machadoleonardo94/Brewers_control_panel/zero-crossing/zero-crossing.step

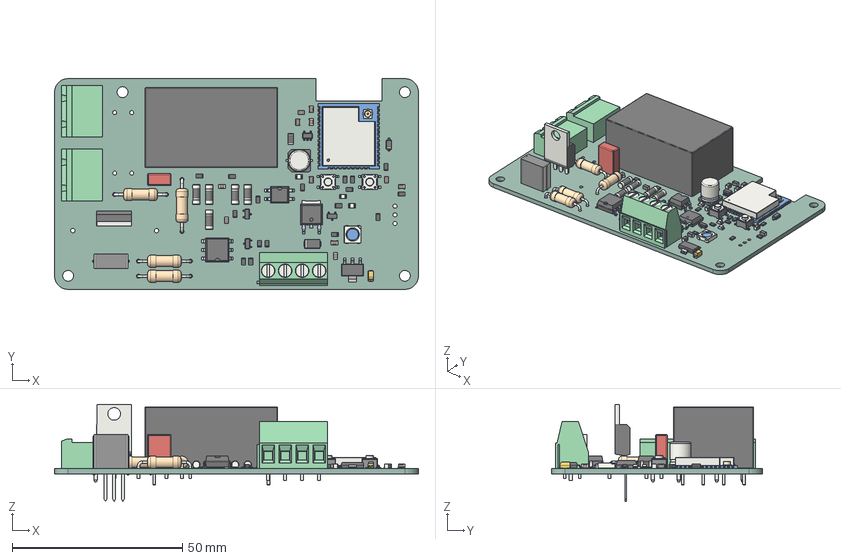
[picture p1: CAD file, 2026-02-01]
zero-crossing/zero-crossing.step
107.0 x 62.0 x 28.5 mm
C_0805_2012Metric x 10
SW_SPST_PTS647Sx38 x 2
R_0805_2012Metric x 17
SMDIP_4_W762mm
D_MELF_Standard x 5
LED_0805_2012Metric x 3
SOT_223
C_Rect_L110mm_W43mm_P1000mm_MKT
C_Elec_63x77
SMDIP_6_W953mm
CQ assembly
D_SOD_123
SOT_23 x 3
TO-220-3_Vertical
LED_WS2812B_PLCC4_50x50mm_P32mm
R_Axial_DIN0411_L99mm_D36mm_P1524mm_Horizontal x 4
ESP32-WROOM-32U
C_Rect_L70mm_W35mm_P500mm
GMSTBA_01x02_G_7_62mm x 2
Converter_ACDC_Hi-Link_HLK-5Mxx
L_0805_2012Metric
TerminalBlock_Phoenix_MKDS_15_4_1x04_P500mm_Horizontal
SOT_23_5
CP_EIA_3216_18_Kemet_A
Fuse_1206_3216Metric
D_SMA
zero-crossing_PCB
