machadoleonardo94/Brewers_control_panel/zero-crossing/zero-crossing.pdf

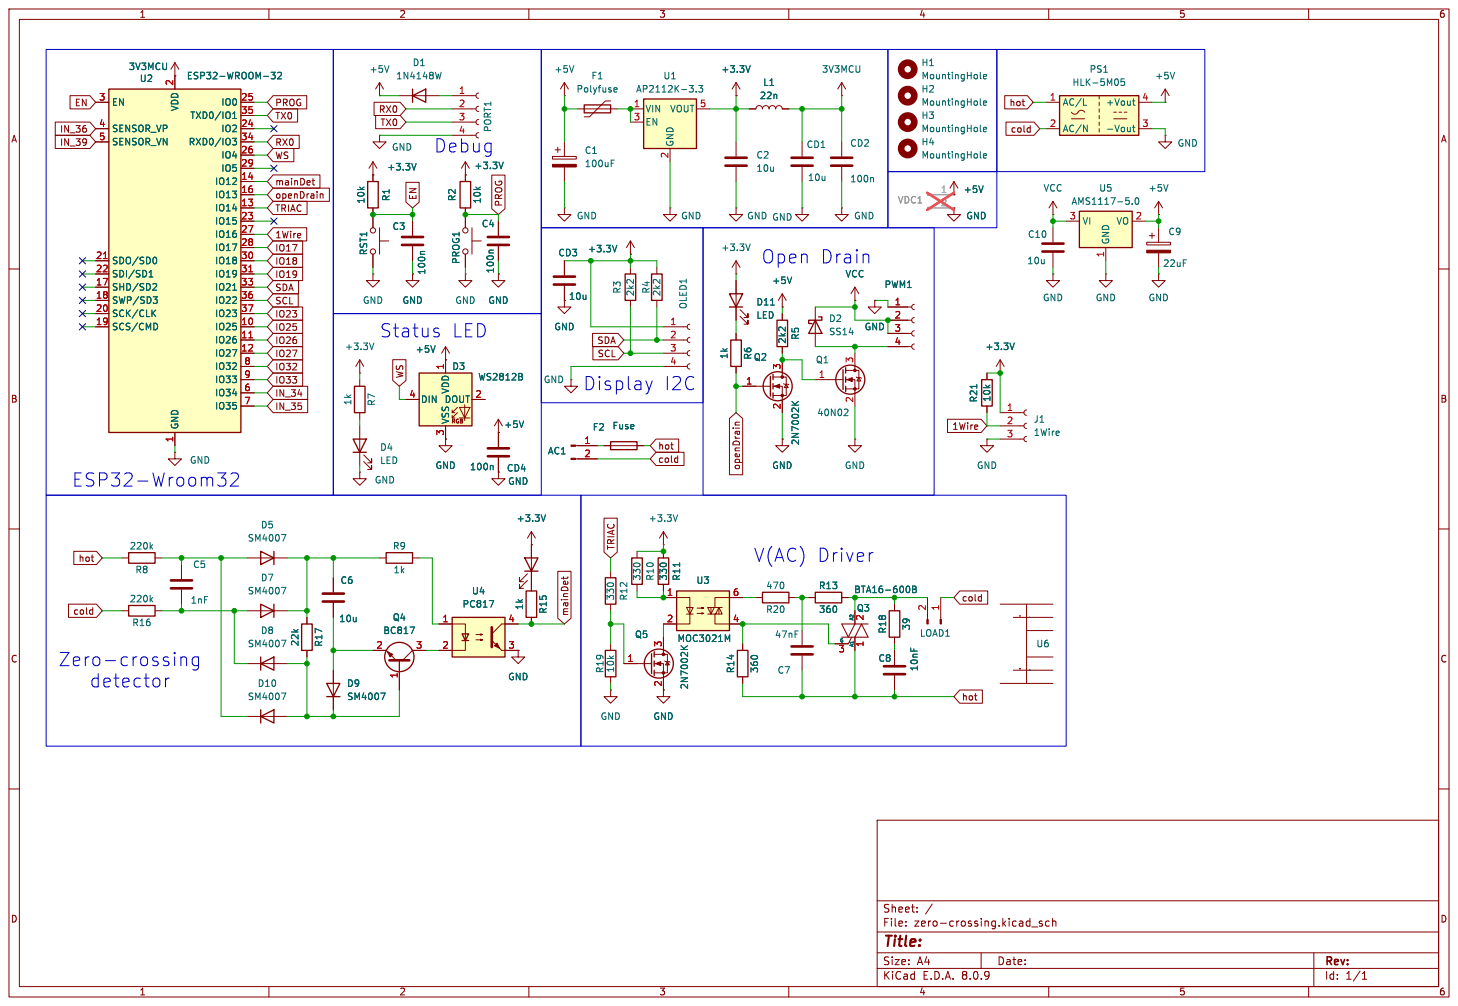
[picture p2: page 1]

2 SCK/CLK 20 SDO/SD0 21 SDI/SD1 22

Id: 1/1 Title: File: zero-crossing.kicad_sch Sheet: /
