machadoleonardo94/Brewers_control_panel/zero-crossing/zero-crossing.kicad_pcb

## KiCad design zero-crossing/zero-crossing.kicad_pcb (2026-02-01)

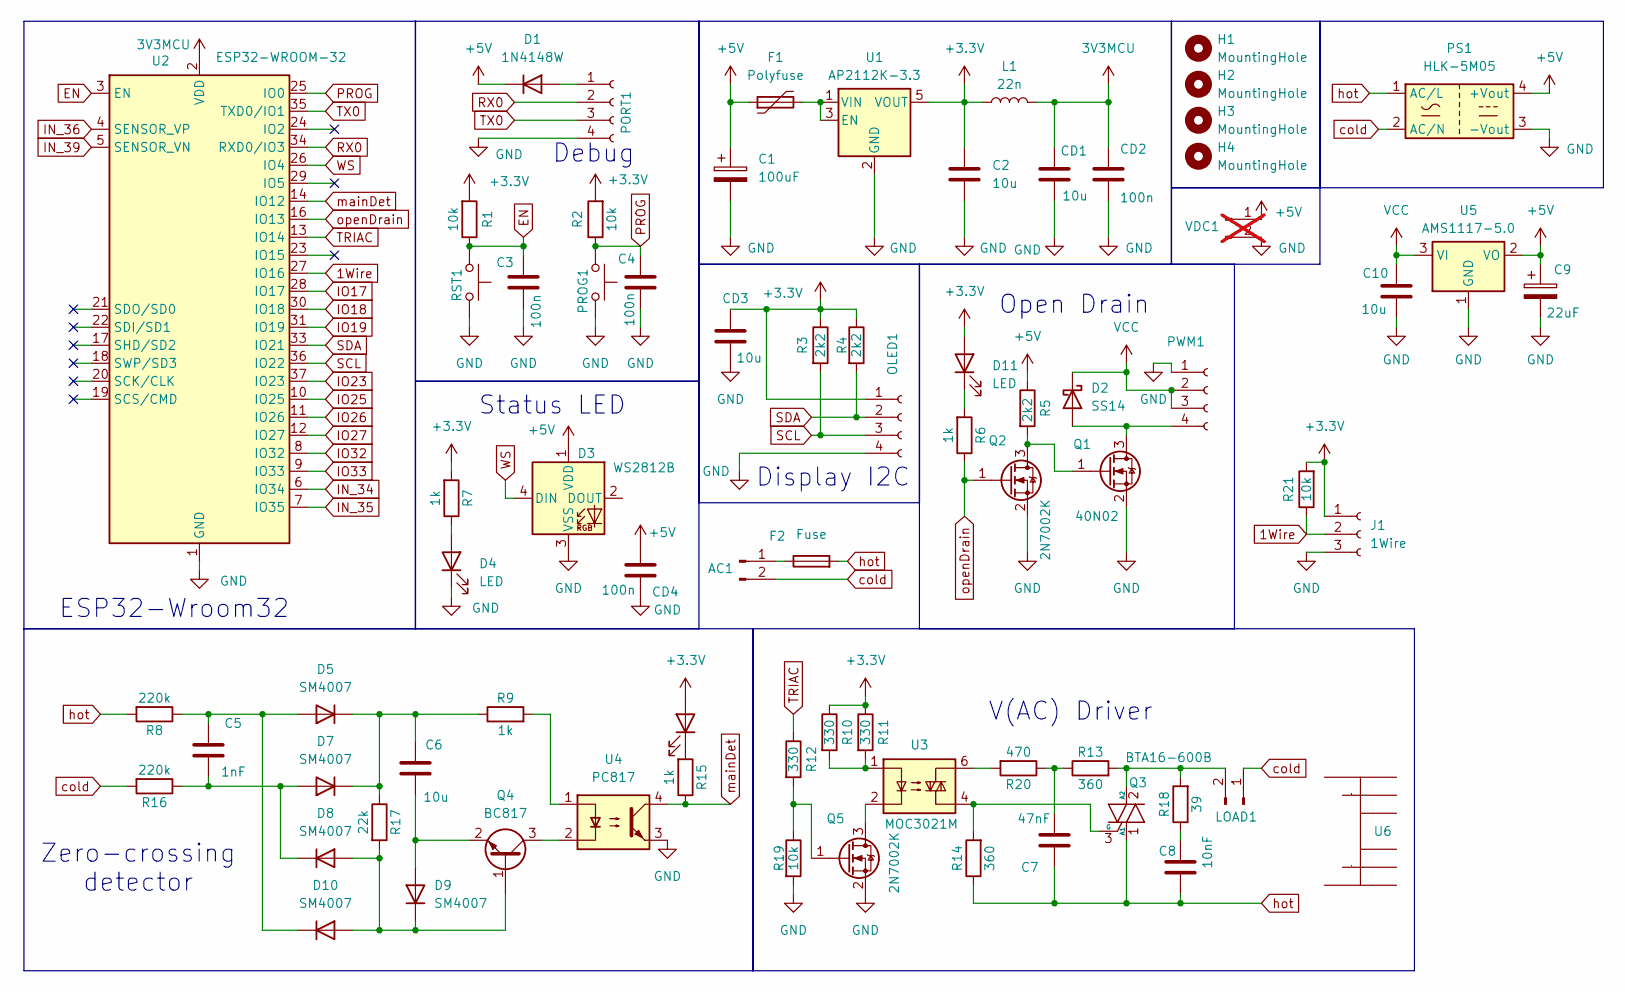
[picture p3: schematic zero-crossing.kicad_sch]

Parts:
AC1: Conn_01x02_Pin; PhoenixContact_GMSTBA_2,5_2-G-7,62_1x02_P7.62mm_Horizontal
C1: 100uF; C_Elec_6.3x7.7; LCSC C99837
C2, C6, C10: 10u; C_0805_2012Metric; LCSC C77075
C3, C4: 100n; C_0805_2012Metric; LCSC C2909631
C5: 1nF; C_0805_2012Metric; Part Number C0805C104J5RALTU; LCSC C2909631
C7: 47nF; C_Rect_L11.0mm_W4.3mm_P10.00mm_MKT; Part Number C0805C104J5RALTU; LCSC C2909631
C8: 10nF; C_Rect_L7.0mm_W3.5mm_P5.00mm; Part Number C0805C104J5RALTU; LCSC C2909631
C9: 22uF; CP_EIA-3216-18_Kemet-A_Pad1.58x1.35mm_HandSolder
CD1, CD3: 10u; C_0805_2012Metric; LCSC C77075
CD2, CD4: 100n; C_0805_2012Metric; LCSC C2909631
D1: 1N4148W; D_SOD-123; LCSC C82544
D2: SS14; D_SMA; LCSC C2909920
D3: WS2812B; LED_WS2812B_PLCC4_5.0x5.0mm_P3.2mm; LCSC 1
D4, D6, D11: LED; LED_0805_2012Metric_Pad1.15x1.40mm_HandSolder; LCSC C84256
D5, D7, D8, D9, D10: SM4007; D_MELF
F1: Polyfuse; Fuse_1206_3216Metric_Pad1.42x1.75mm_HandSolder; LCSC C22446878
F2: Fuse; Fuseholder_Clip-5x20mm_Bel_FC-203-22_Lateral_P17.80x5.00mm_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
H1, H2, H3, H4: MountingHole; MountingHole_3.2mm_M3
J1: 1Wire; TerminalBlock_Xinya_XY308-2.54-3P_1x03_P2.54mm_Horizontal
L1: 22n; L_0805_2012Metric; LCSC 1
LOAD1: Conn_01x02_Pin; PhoenixContact_GMSTBA_2,5_2-G-7,62_1x02_P7.62mm_Horizontal
OLED1: Conn_01x04_Socket; Hirose_DF13C_CL535-0404-8-51_1x04-1MP_P1.25mm_Vertical; LCSC 1
PORT1: Conn_01x04_Socket; Hirose_DF13C_CL535-0404-8-51_1x04-1MP_P1.25mm_Vertical; LCSC 1
PROG1: SW_Push; SW_SPST_PTS647_Sx38; LCSC C455246
PS1: HLK-5M05; Converter_ACDC_Hi-Link_HLK-5Mxx
PWM1: Conn_01x03_Socket; TerminalBlock_Phoenix_MKDS-1,5-4_1x04_P5.00mm_Horizontal
Q1: 40N02; TO-252-2
Q2, Q5: 2N7002K; SOT-23; LCSC C65189
Q3: BTA16-600B; TO-220-3_Vertical; LCSC C7471857
Q4: BC817; SOT-23
R1, R2, R19, R21: 10k; R_0805_2012Metric; LCSC C17414
R3, R4, R5: 2k2; R_0805_2012Metric; LCSC C17520
R6, R7, R9, R15: 1k; R_0805_2012Metric; LCSC C95781
R8, R16: 220k; R_0805_2012Metric; LCSC C95781
R10, R11, R12: 330; R_0805_2012Metric; LCSC C17630
R13, R14: 360; R_Axial_DIN0411_L9.9mm_D3.6mm_P15.24mm_Horizontal; LCSC C95781
R17: 22k; R_0805_2012Metric; LCSC C95781
R18: 39; R_Axial_DIN0411_L9.9mm_D3.6mm_P15.24mm_Horizontal; LCSC C95781
R20: 470; R_Axial_DIN0411_L9.9mm_D3.6mm_P15.24mm_Horizontal; LCSC C95781
RST1: SW_Push; SW_SPST_PTS647_Sx38; LCSC C455246
U1: AP2112K-3.3; SOT-23-5; LCSC C51118
U2: ESP32-WROOM-32; ESP32-WROOM-32U; LCSC C2980301
U3: MOC3021M; SMDIP-6_W9.53mm; LCSC C115465
U4: PC817; SMDIP-4_W7.62mm; LCSC C5451664
U5: AMS1117-5.0; SOT-223-3_TabPin2
U6: HEATSINK-TH_L34.0-W12.0; Manufacturer Part 34X12-25; LCSC Part Name 文豪永顺 34X12-25
VDC1: Conn_01x02_Pin; TerminalBlock_Phoenix_MKDS-1,5-2-5.08_1x02_P5.08mm_Horizont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; not fitted

Connections:
1Wire: J1.2, R21.1, U2.27 (IO16)
3V3MCU: CD1.1, CD2.1, L1.2, U2.2 (VDD)
+3.3V: C2.1, CD3.1, D6.2 (A), D11.2 (A), J1.1, L1.1, OLED1.1, R1.2, R2.2, R3.1, R4.1, R7.2, R10.1, R11.1, R21.2, U1.5 (VOUT)
+5V: C1.1, C9.1, CD4.1, D1.1 (K), D3.1 (VDD), F1.1, PS1.4 (+Vout), R5.1, U5.2 (VO), VDC1.1
EN: C3.1, R1.1, RST1.2, U2.3 (EN)
GND: C1.2, C2.2, C3.2, C4.2, C9.2, C10.2, CD1.2, CD2.2, CD3.2, CD4.2, D3.3 (VSS), D4.1 (K), J1.3, OLED1.4, PORT1.4, PROG1.1, PS1.3 (-Vout), PWM1.1, Q1.2 (S), Q2.2 (S), Q5.2 (S), R19.2, RST1.1, U1.2 (GND), U2.1 (GND), U2.15 (GND), U2.38 (GND), U2.39 (GND), U4.3, U5.1 (GND), VDC1.2
IN_34: U2.6 (IO34)
IN_35: U2.7 (IO35)
IN_36: U2.4 (SENSOR_VP)
IN_39: U2.5 (SENSOR_VN)
IO17: U2.28 (IO17)
IO18: U2.30 (IO18)
IO19: U2.31 (IO19)
IO23: U2.37 (IO23)
IO25: U2.10 (IO25)
IO26: U2.11 (IO26)
IO27: U2.12 (IO27)
IO32: U2.8 (IO32)
IO33: U2.9 (IO33)
unnamed: AC1.1, F2.1
unnamed: C7.1, R13.1, R20.1
unnamed: C8.2, R18.1
unnamed: D1.2 (A), PORT1.1
unnamed: D2.2 (A), PWM1.4, Q1.3 (D)
unnamed: D4.2 (A), R7.1
unnamed: C6.1, D5.1 (K), D7.1 (K), R9.1, R17.1
unnamed: D6.1 (K), R15.2
unnamed: C5.1, D7.2 (A), D8.1 (K), R16.1
unnamed: C6.2, D9.2 (A), Q4.2 (E)
unnamed: D8.2 (A), D9.1 (K), D10.2 (A), Q4.1 (B), R17.2
unnamed: C5.2, D5.2 (A), D10.1 (K), R8.1
unnamed: D11.1 (K), R6.2
unnamed: LOAD1.2, Q3.2 (A2), R13.2, R18.2
unnamed: Q1.1 (G), Q2.3 (D), R5.2
unnamed: Q3.3 (G), R14.2, U3.4
unnamed: Q4.3 (C), U4.2
unnamed: Q5.3 (D), U3.2
unnamed: Q5.1 (G), R12.2, R19.1
unnamed: R9.2, U4.1
unnamed: R10.2, R11.2, U3.1
unnamed: R20.2, U3.6
unnamed: F1.2, U1.1 (VIN), U1.3 (EN)
PROG: C4.1, PROG1.2, R2.1, U2.25 (IO0)
RX0: PORT1.2, U2.34 (RXD0/IO3)
SCL: OLED1.3, R3.2, U2.36 (IO22)
SDA: OLED1.2, R4.2, U2.33 (IO21)
TRIAC: R12.1, U2.13 (IO14)
TX0: PORT1.3, U2.35 (TXD0/IO1)
VCC: C10.1, D2.1 (K), PWM1.2, PWM1.3, U5.3 (VI)
WS: D3.4 (DIN), U2.26 (IO4)
cold: AC1.2, LOAD1.1, PS1.2 (AC/N), R16.2
hot: C7.2, C8.1, F2.2, PS1.1 (AC/L), Q3.1 (A1), R8.2, R14.1
mainDet: R15.1, U2.14 (IO12), U4.4
openDrain: Q2.1 (G), R6.1, U2.16 (IO13)

Notes on the sheet:
Zero-crossing detector
Status LED
Display I2C
V(AC) Driver
Debug
ESP32-Wroom32
Open Drain

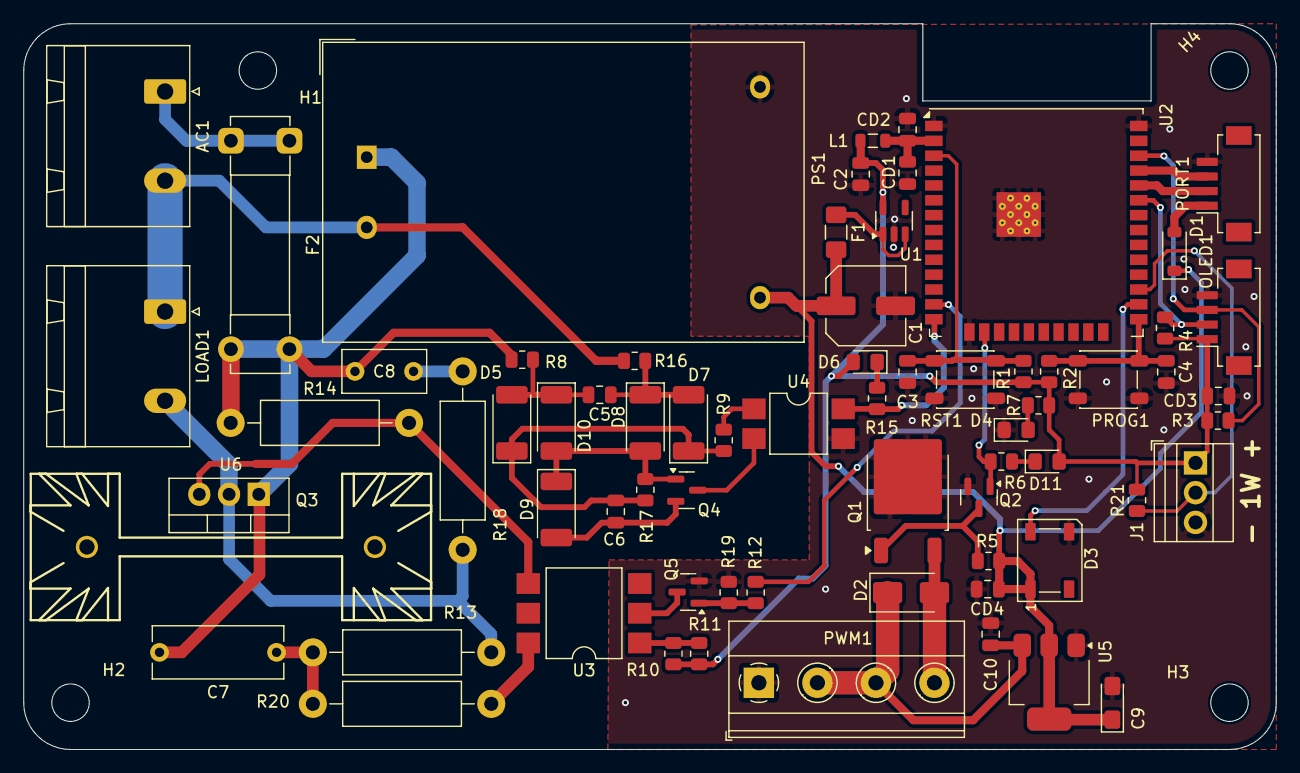
[picture p4: board zero-crossing.kicad_pcb from above]

Board: 2 copper layers, 107.0 x 62.0 mm, 73 parts (0 on the bottom side), 41 nets.
