machadoleonardo94/Brewers_control_panel/(commit log)

2026-02-01 Initial release
    [bom.csv, designators.csv, positions.csv, zero-crossing.kicad_pcb, zero-crossing.kicad_sch, zero-crossing.step]
2026-02-01 Added PDF schematics
2026-02-17 ESPHome
    Initial firmware for ESPHome.
    Includes PID controller, manual and auto tuning of parameters
    [Triac-Controller.yaml]
